erdemcanaz/MODBUS/README.md

# LoRa_Modbus
The goal of this project is to design a hardware implementation that enables wireless Modbus communication using the LoRa protocol.
