erdemcanaz/MODBUS/Device PCBs/Device-1/files/3D_image_1.png

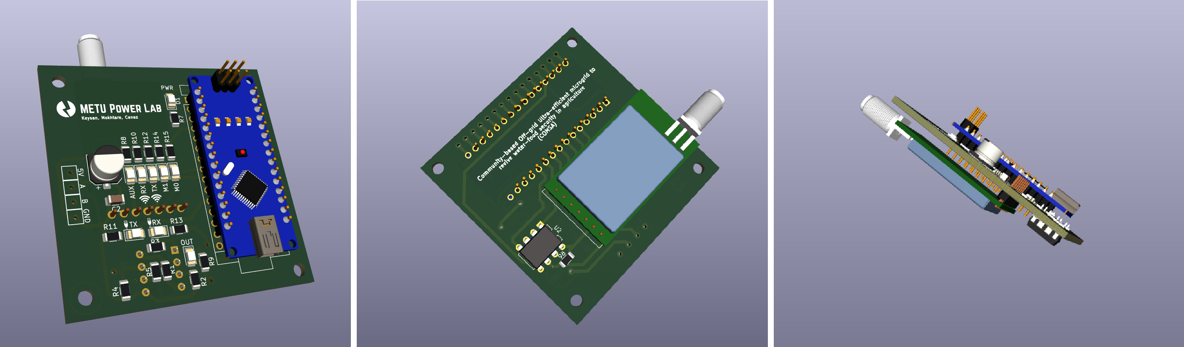
Device PCBs/Device-1/files/3D_image_1.png
