erdemcanaz/MODBUS/Device PCBs/Device-1/files/e32-433t20dt-1.snapshot.2/Anteckning 2020-03-28 171103.png

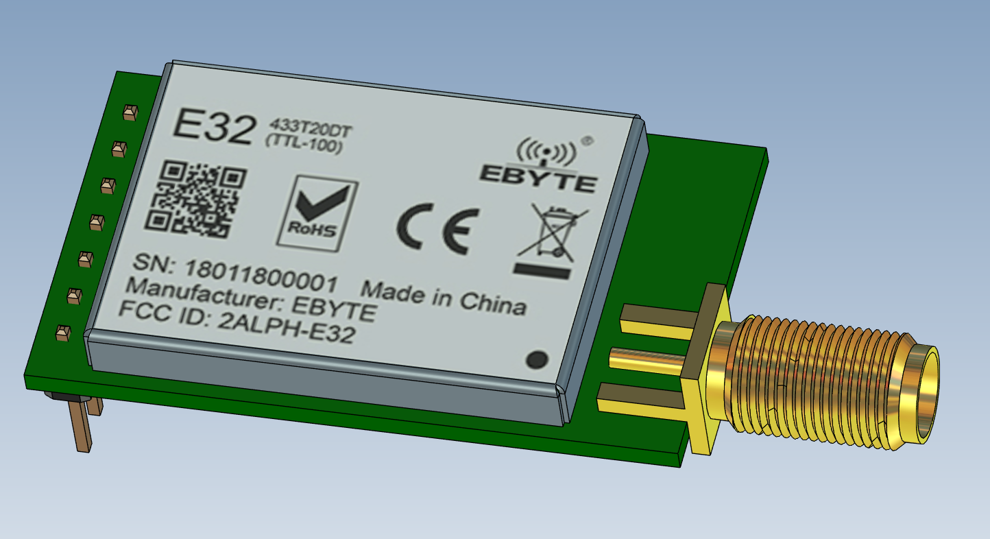
Device PCBs/Device-1/files/e32-433t20dt-1.snapshot.2/Anteckning 2020-03-28 171103.png
