erdemcanaz/MODBUS/Device PCBs/Device-1/files/example_RS485-TTL-schmatic.png

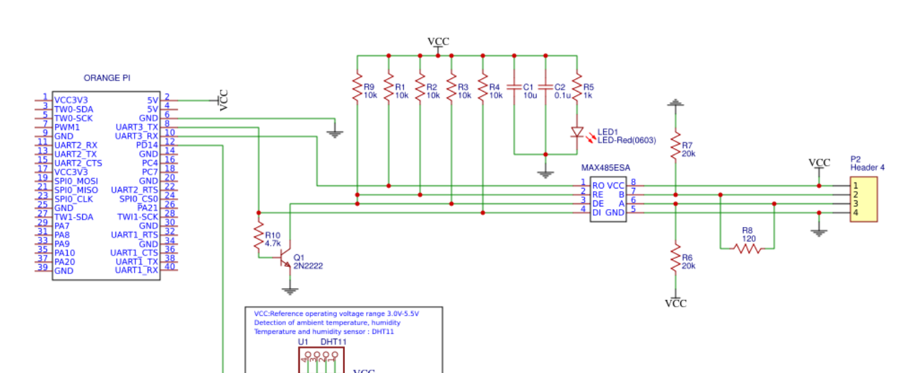
Device PCBs/Device-1/files/example_RS485-TTL-schmatic.png
