erdemcanaz/MODBUS/Device PCBs/Device-1/files/images.png

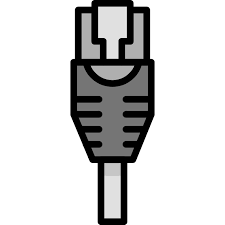
Device PCBs/Device-1/files/images.png
