erdemcanaz/MODBUS/Device PCBs/Device-1/files/render2.png

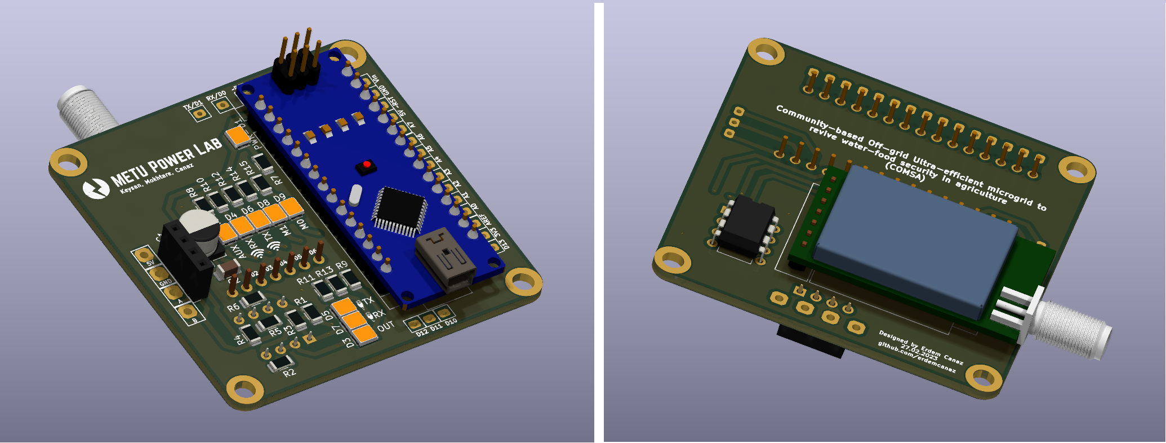
Device PCBs/Device-1/files/render2.png
