erdemcanaz/MODBUS/Device PCBs/Device-1/files/render.png

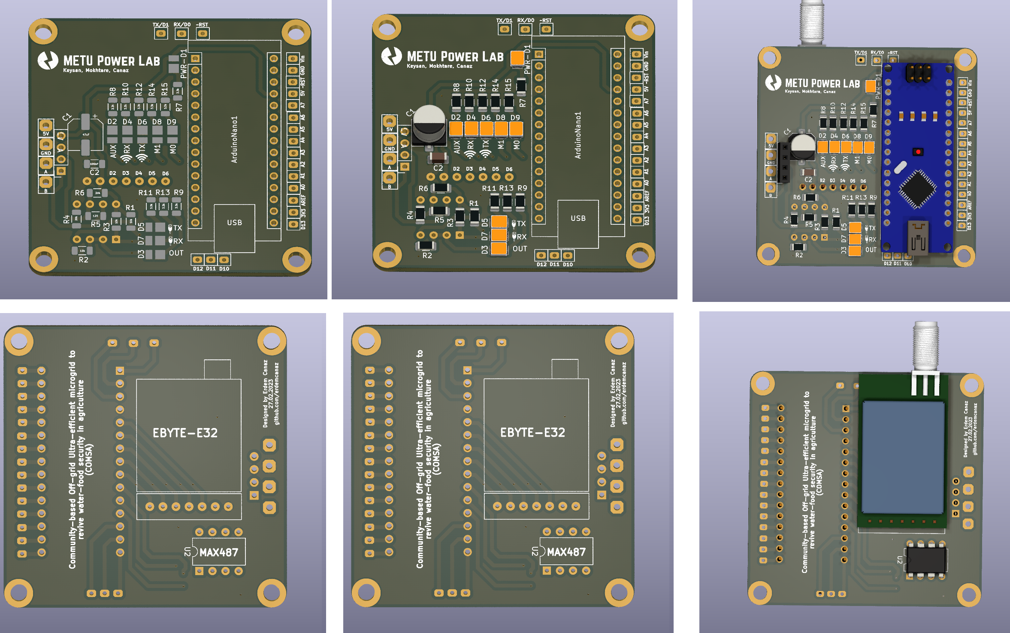
Device PCBs/Device-1/files/render.png
