erdemcanaz/MODBUS/Device PCBs/Device-1/files/RS485-TTL.png

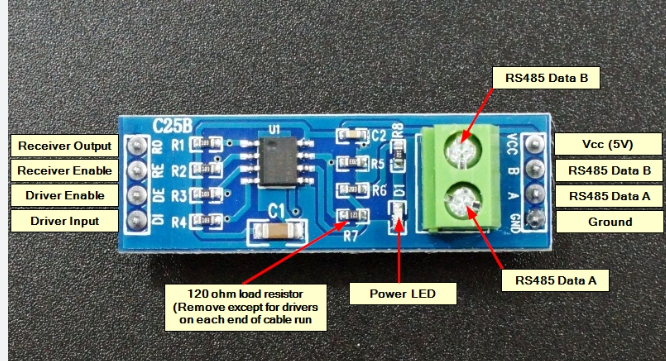
Device PCBs/Device-1/files/RS485-TTL.png
