erdemcanaz/MODBUS/Device PCBs/Device-1/files/samsung-lm281b-1.snapshot.3/lm281b/screenshot2.JPG

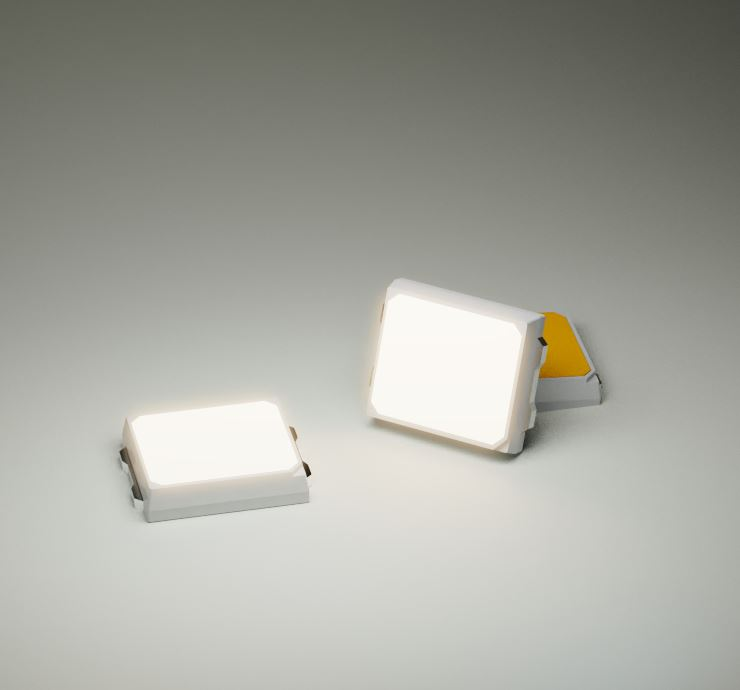
Device PCBs/Device-1/files/samsung-lm281b-1.snapshot.3/lm281b/screenshot2.JPG
