erdemcanaz/MODBUS/Device PCBs/Device-1/files/samsung-lm281b-1.snapshot.3/lm281b/screenshot.JPG

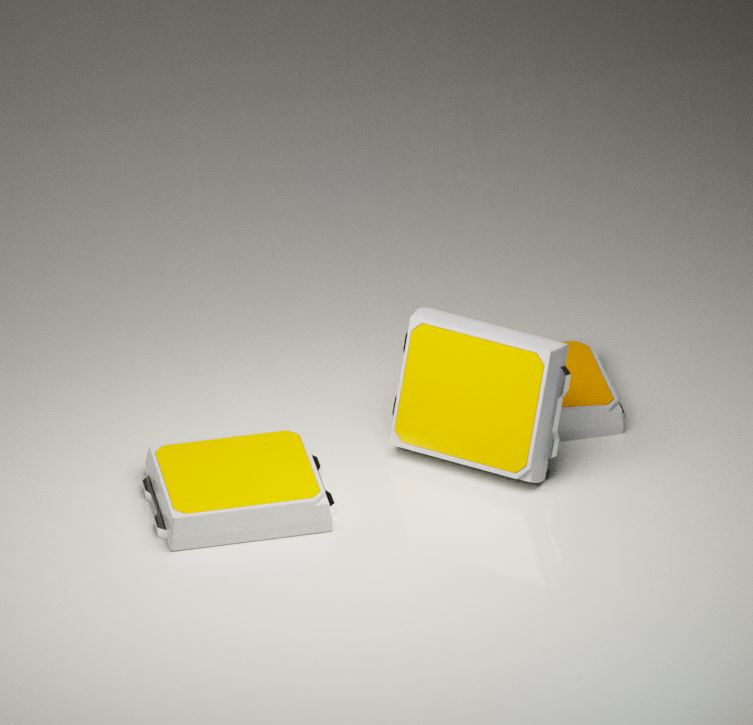
Device PCBs/Device-1/files/samsung-lm281b-1.snapshot.3/lm281b/screenshot.JPG
