erdemcanaz/MODBUS/Device PCBs/Device-1/files/wifi-chargement-gratuit-png-vecteurs-35.png

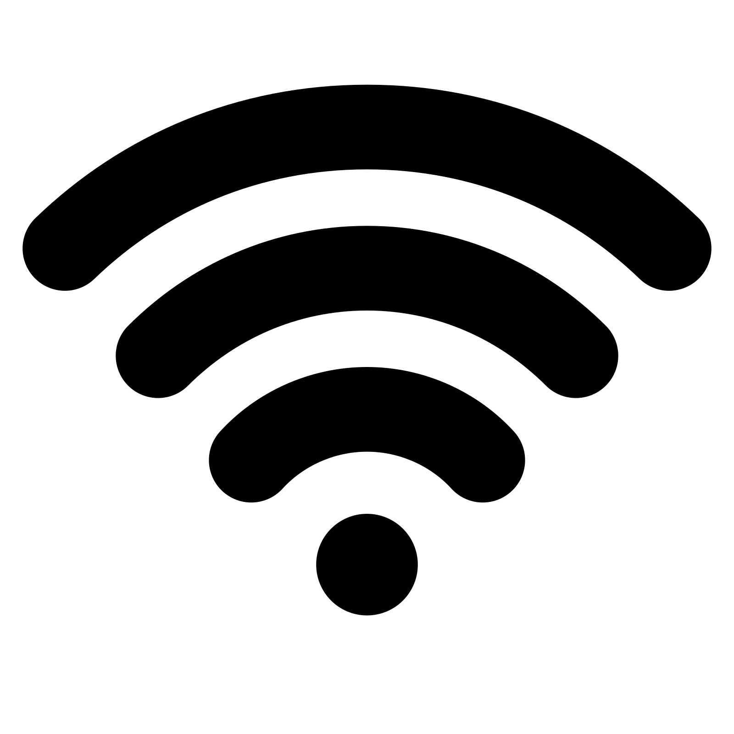
Device PCBs/Device-1/files/wifi-chargement-gratuit-png-vecteurs-35.png
