erdemcanaz/MODBUS/3D parts/Raspberry_Pi_3B__Case_3361218/README.txt

Raspberry Pi 3B+ Case by mkellsy on Thingiverse: https://www.thingiverse.com/thing:3361218
