erdemcanaz/MODBUS/3D parts/Raspberry_Pi_3B__Case_3361218/images/featured_preview_RPI3-1.PNG

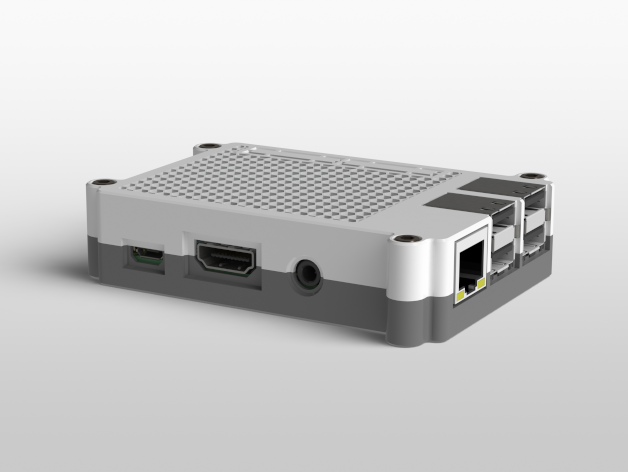
3D parts/Raspberry_Pi_3B__Case_3361218/images/featured_preview_RPI3-1.PNG
