erdemcanaz/MODBUS/Device PCBs/Device-1/files/samsung-lm281b-1.snapshot.3/lm281b/cad/lm281b full assembly.stp

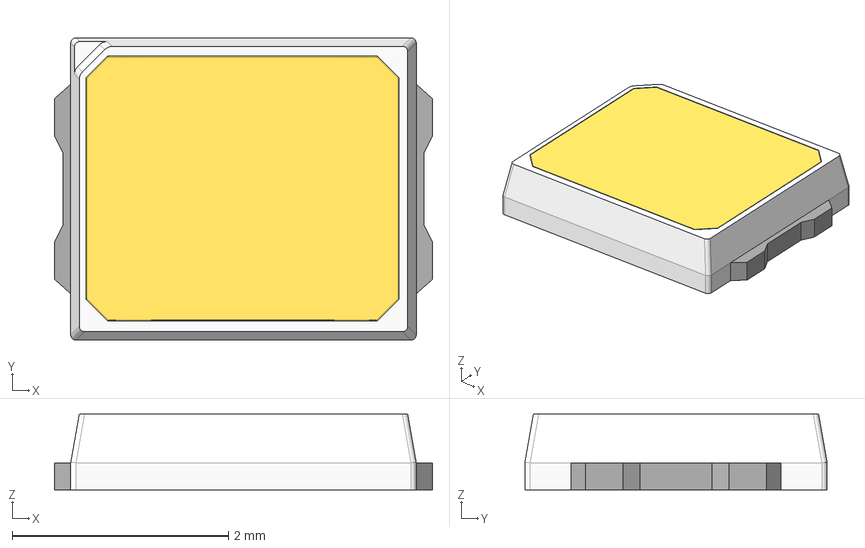
[picture p16: CAD file, 2023-05-01]
Device PCBs/Device-1/files/samsung-lm281b-1.snapshot.3/lm281b/cad/lm281b full assembly.stp
3.50 x 2.80 x 0.7 mm
lm281b body
lm281b luminofor
lm281b contact
