erdemcanaz/MODBUS/3D parts/Raspberry_Pi_3B__Case_3361218/files/RPI-BOARD-RETAINER.STL

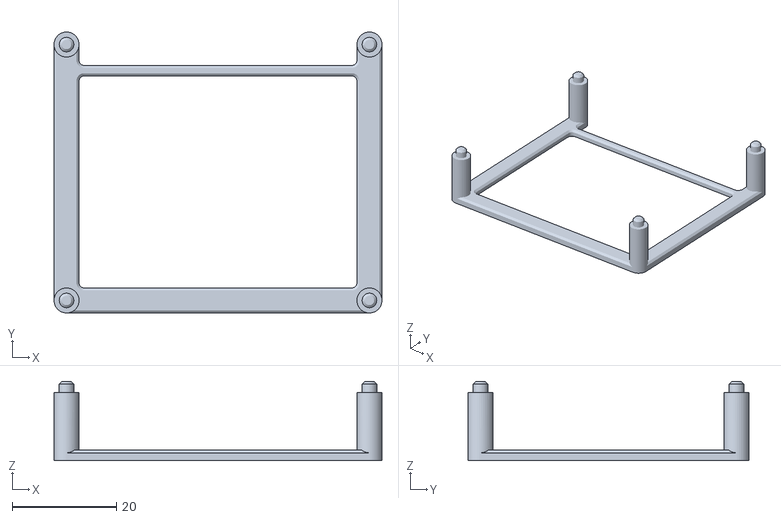
[picture p17: CAD file, 2023-06-25]
3D parts/Raspberry_Pi_3B__Case_3361218/files/RPI-BOARD-RETAINER.STL
62.8 x 53.8 x 15.2
