erdemcanaz/MODBUS/Device PCBs/Device-1/files/arduino-nano-30.snapshot.1/Arduino Nano.SLDPRT

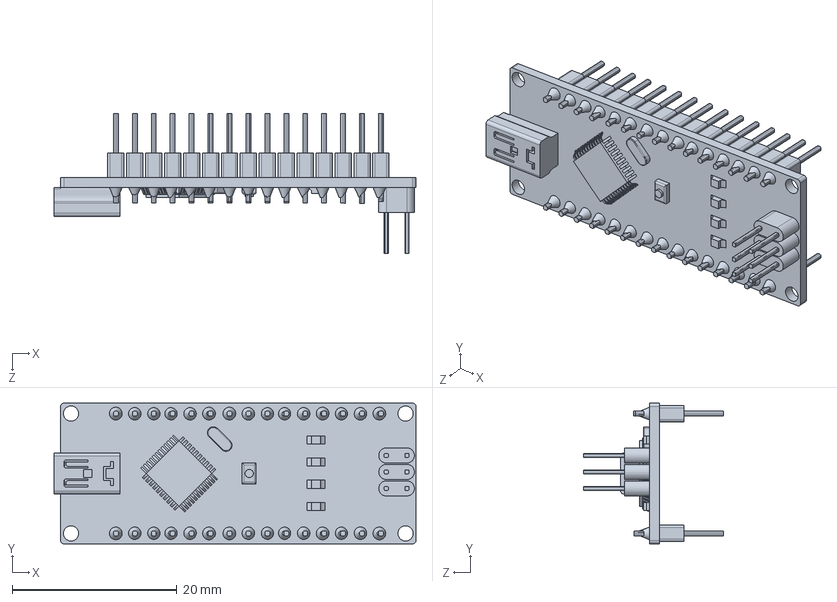
[picture p18: CAD file, 2023-05-01]
Device PCBs/Device-1/files/arduino-nano-30.snapshot.1/Arduino Nano.SLDPRT
44.0 x 17.1 x 17.0 mm
