erdemcanaz/MODBUS/Device PCBs/Device-1/files/e32-433t20dt-1.snapshot.2/E32-433T20DT.stp

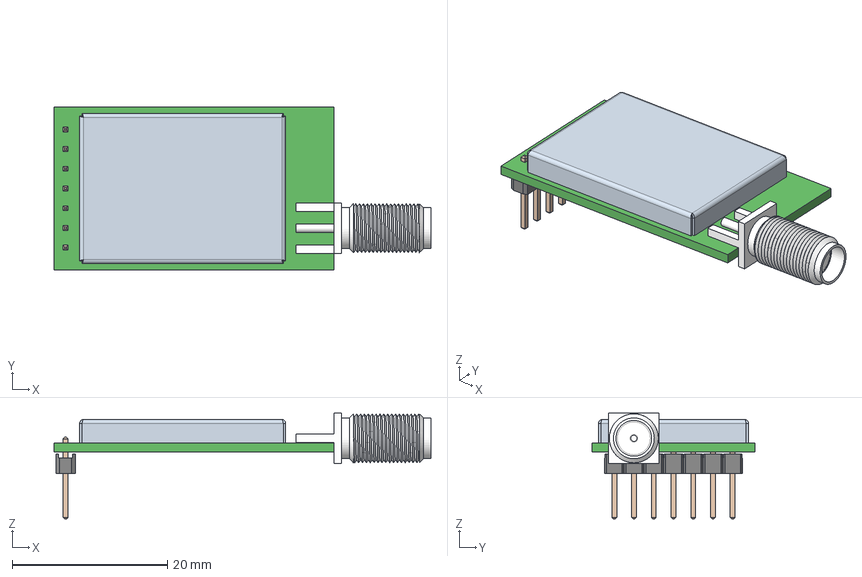
[picture p19: CAD file, 2023-05-01]
Device PCBs/Device-1/files/e32-433t20dt-1.snapshot.2/E32-433T20DT.stp
48.5 x 21.0 x 13.6 mm
Pin x 7
Spin
Base
PCB
RFbox
