erdemcanaz/MODBUS/3D parts/Lora Casing V9.stl

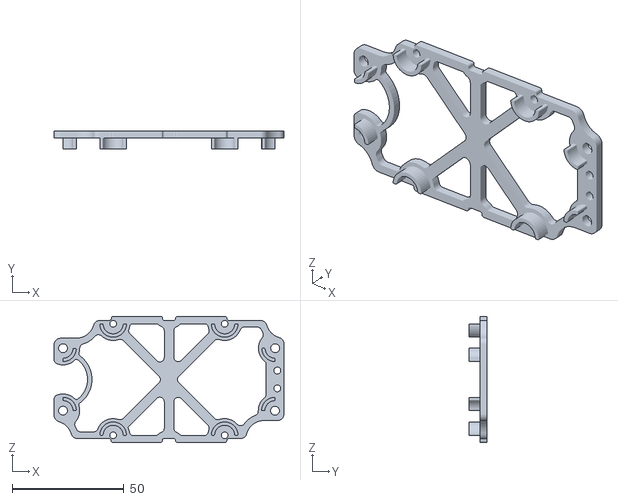
[picture p20: CAD file, 2023-05-01]
3D parts/Lora Casing V9.stl
103.1 x 8.00 x 56.5
