erdemcanaz/MODBUS/3D parts/Raspberry_Pi_3B__Case_3361218/files/RPI-TOP-25FAN-BLANK.STL

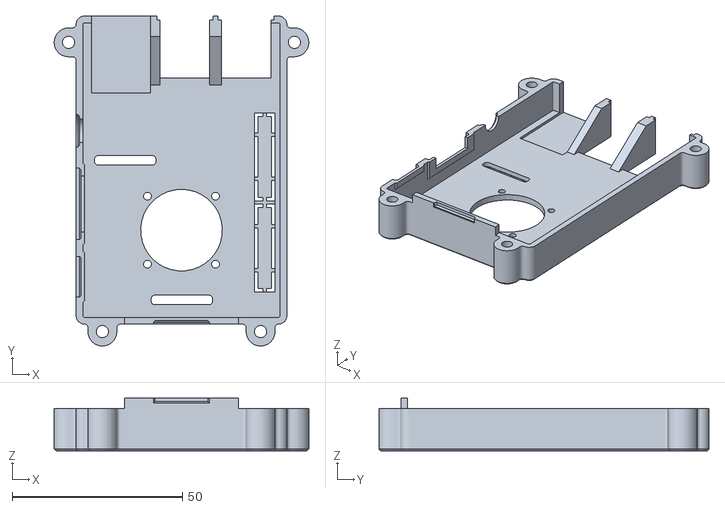
[picture p21: CAD file, 2023-06-25]
3D parts/Raspberry_Pi_3B__Case_3361218/files/RPI-TOP-25FAN-BLANK.STL
74.9 x 97.0 x 15.5
