erdemcanaz/MODBUS/3D parts/Raspberry_Pi_3B__Case_3361218/files/RPI-BOTTOM-100VESA.STL

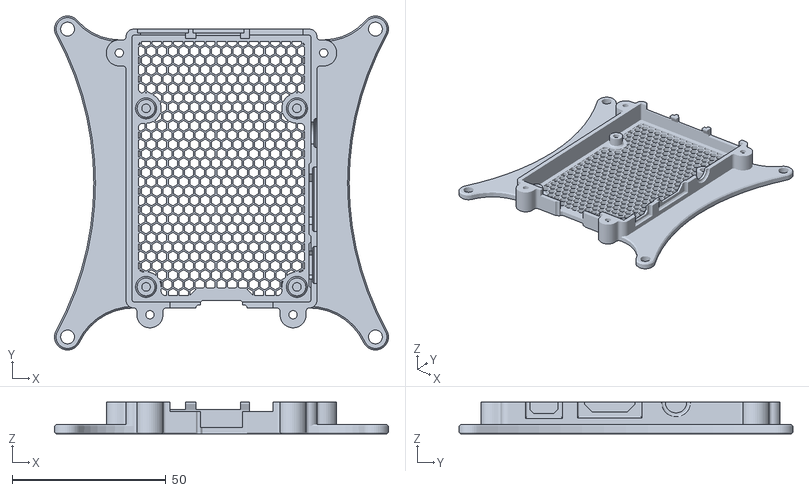
[picture p22: CAD file, 2023-06-25]
3D parts/Raspberry_Pi_3B__Case_3361218/files/RPI-BOTTOM-100VESA.STL
108.5 x 108.5 x 10.3
