erdemcanaz/MODBUS/3D parts/Raspberry_Pi_3B__Case_3361218/files/RPI-TOP-25FAN.STL

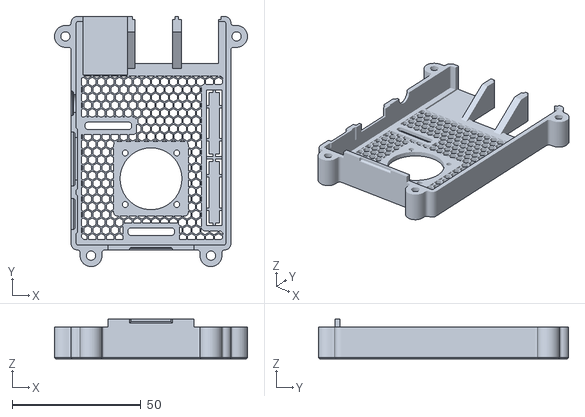
[picture p25: CAD file, 2023-06-25]
3D parts/Raspberry_Pi_3B__Case_3361218/files/RPI-TOP-25FAN.STL
74.9 x 97.0 x 15.5
