erdemcanaz/MODBUS/3D parts/Raspberry_Pi_3B__Case_3361218/files/RPI-BOTTOM.STL

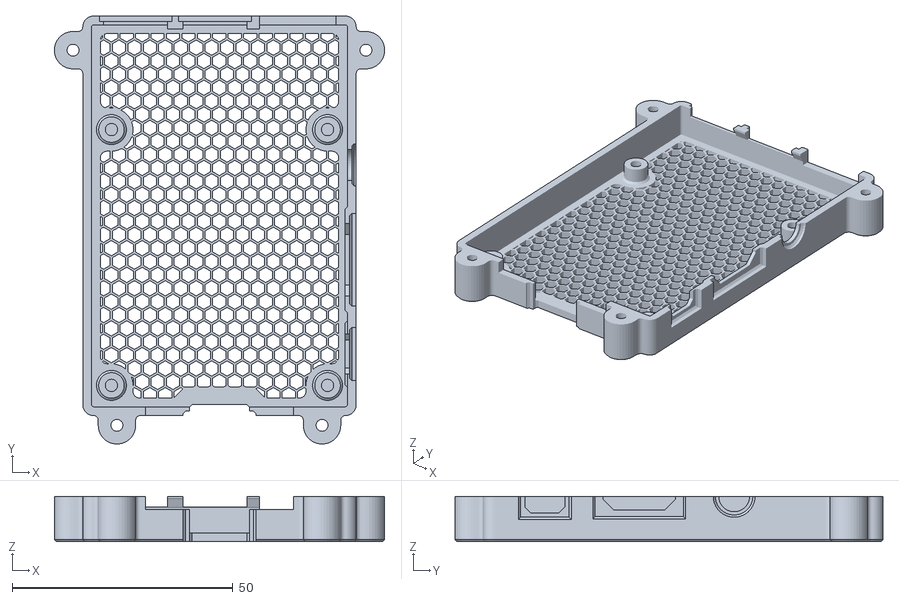
[picture p26: CAD file, 2023-06-25]
3D parts/Raspberry_Pi_3B__Case_3361218/files/RPI-BOTTOM.STL
74.9 x 97.0 x 10.3
