erdemcanaz/MODBUS/3D parts/Raspberry_Pi_3B__Case_3361218/files/RPI-BOTTOM-8020.STL

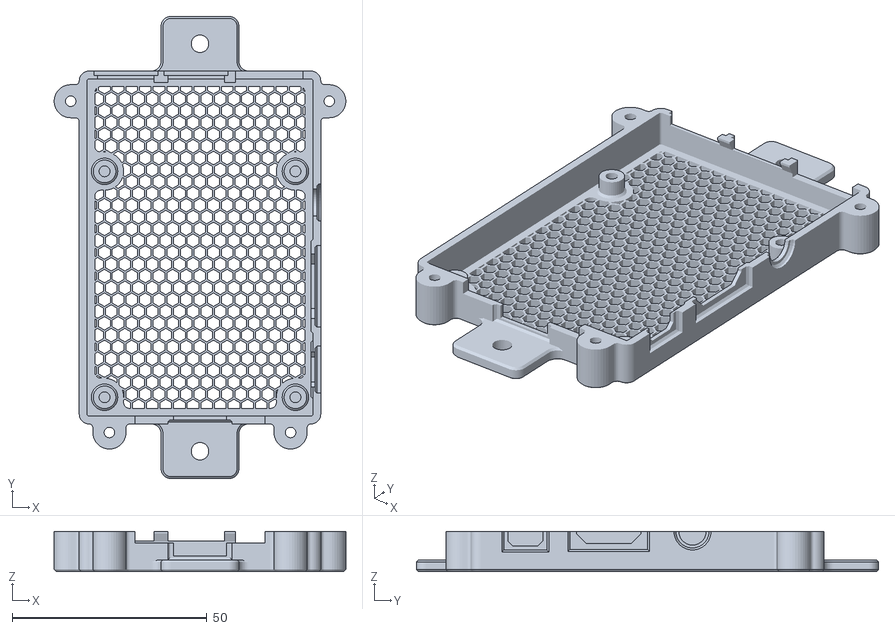
[picture p28: CAD file, 2023-06-25]
3D parts/Raspberry_Pi_3B__Case_3361218/files/RPI-BOTTOM-8020.STL
74.9 x 118.6 x 10.3
