erdemcanaz/MODBUS/3D parts/Raspberry_Pi_3B__Case_3361218/files/RPI-BOTTOM-75VESA.STL

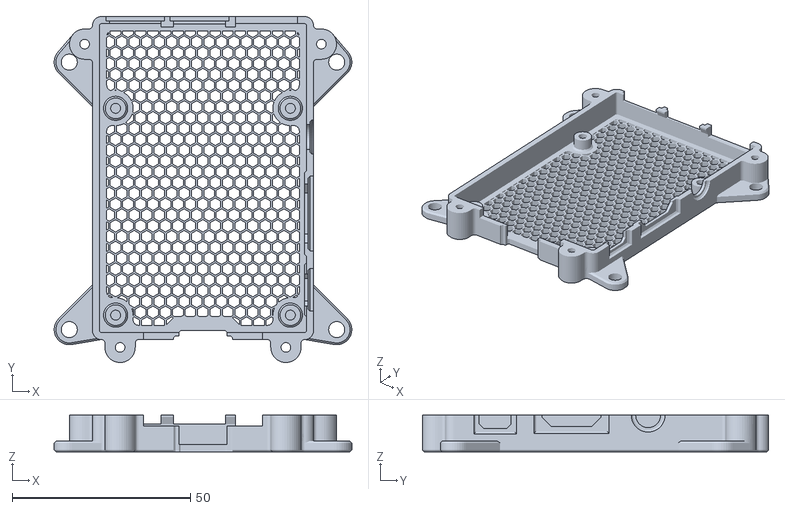
[picture p29: CAD file, 2023-06-25]
3D parts/Raspberry_Pi_3B__Case_3361218/files/RPI-BOTTOM-75VESA.STL
83.5 x 97.0 x 10.3
