erdemcanaz/MODBUS/(list of files, cad)

Other CAD files:
Device PCBs/Device-1/files/arduino-nano-30.snapshot.1/Arduino Nano-STEP.STEP
3D parts/Raspberry_Pi_3B__Case_3361218/files/RPI-TOP-30FAN-BLANK.STL
3D parts/Raspberry_Pi_3B__Case_3361218/files/RPI-TOP-BLANK.STL
3D parts/Raspberry_Pi_3B__Case_3361218/files/RPI-TOP-30FAN.STL
3D parts/lora casing v8.stl
Device PCBs/Device-1/files/e32-433t20dt-1.snapshot.2/e32-433t20dt.X_T
Device PCBs/Device-1/files/samsung-lm281b-1.snapshot.3/lm281b/cad/lm281b body.prt
Device PCBs/Device-1/files/samsung-lm281b-1.snapshot.3/lm281b/cad/lm281b contact.prt
Device PCBs/Device-1/files/samsung-lm281b-1.snapshot.3/lm281b/cad/lm281b full assembly.obj
Device PCBs/Device-1/files/samsung-lm281b-1.snapshot.3/lm281b/cad/lm281b full assembly.prt
Device PCBs/Device-1/files/samsung-lm281b-1.snapshot.3/lm281b/cad/lm281b luminofor.prt
