erdemcanaz/MODBUS/Device PCBs/Device-1/files/schematic_25_02_2023.pdf

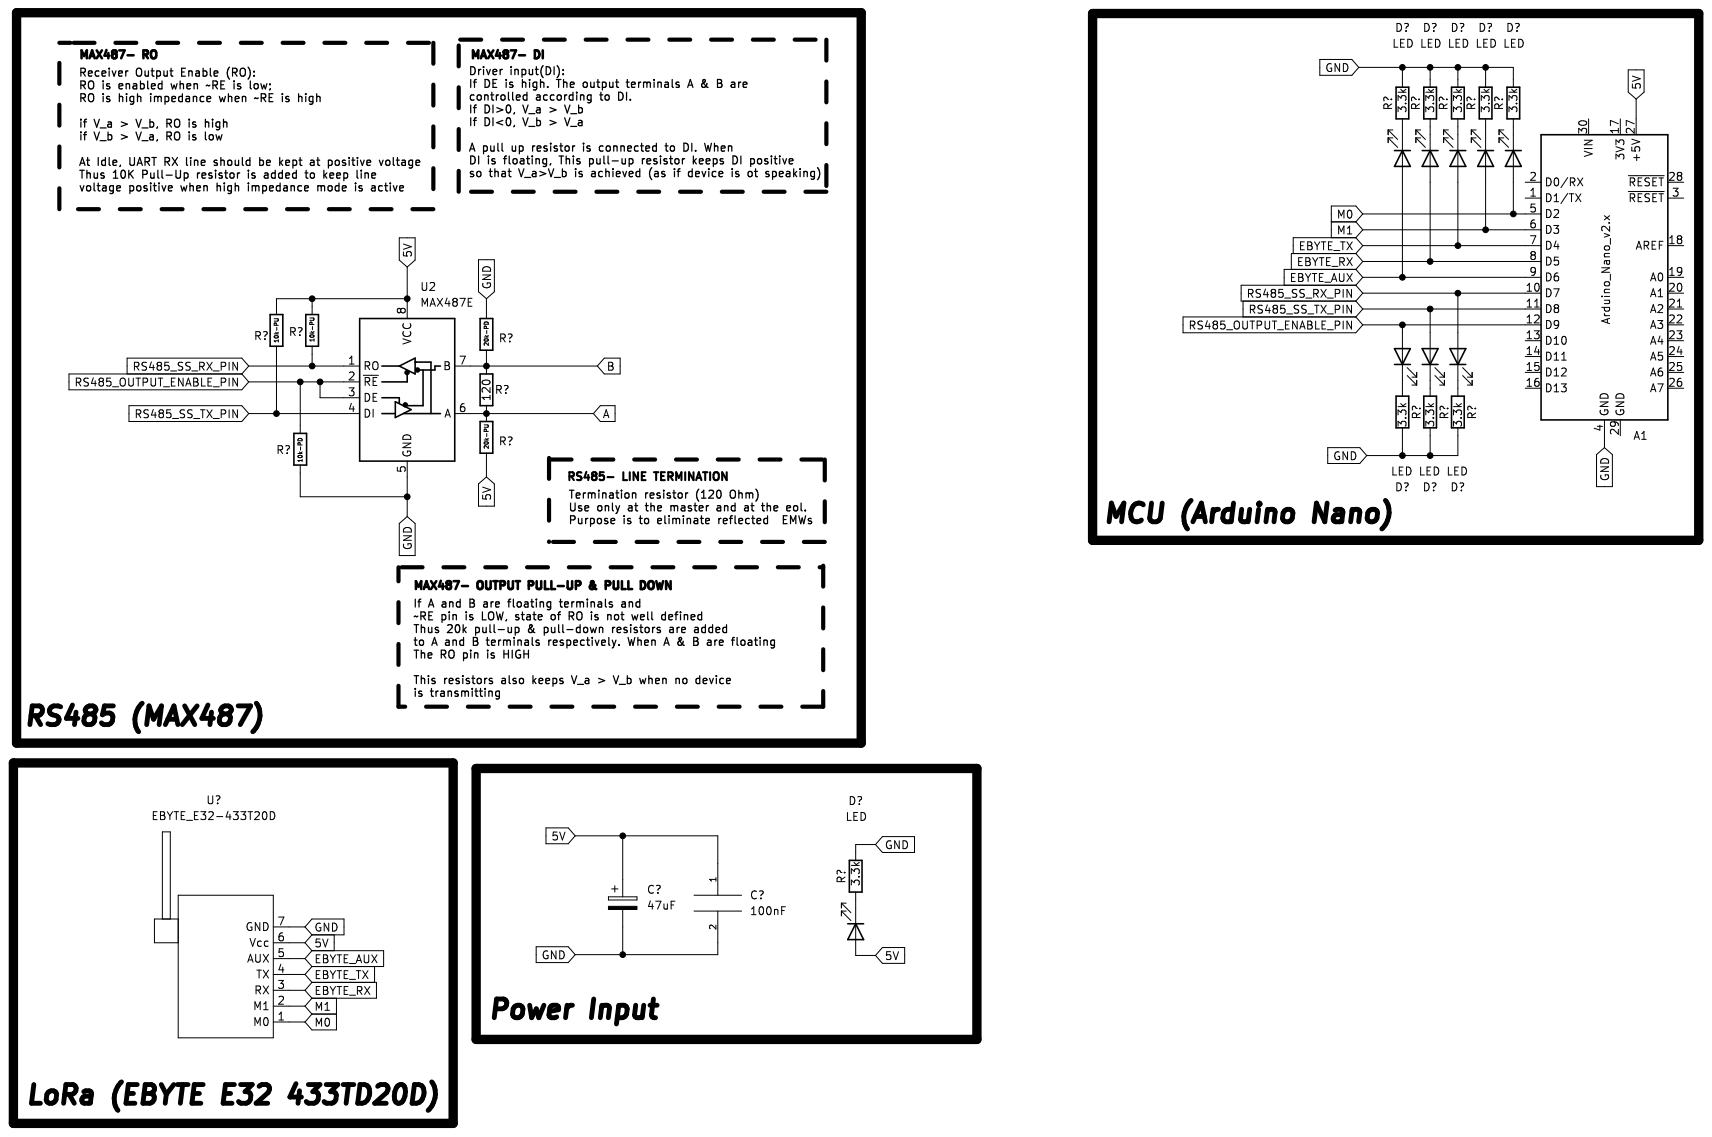
[picture p38: page 1]
