erdemcanaz/MODBUS/Device PCBs/Device-1/files/schematic_25_02_2023_2.pdf

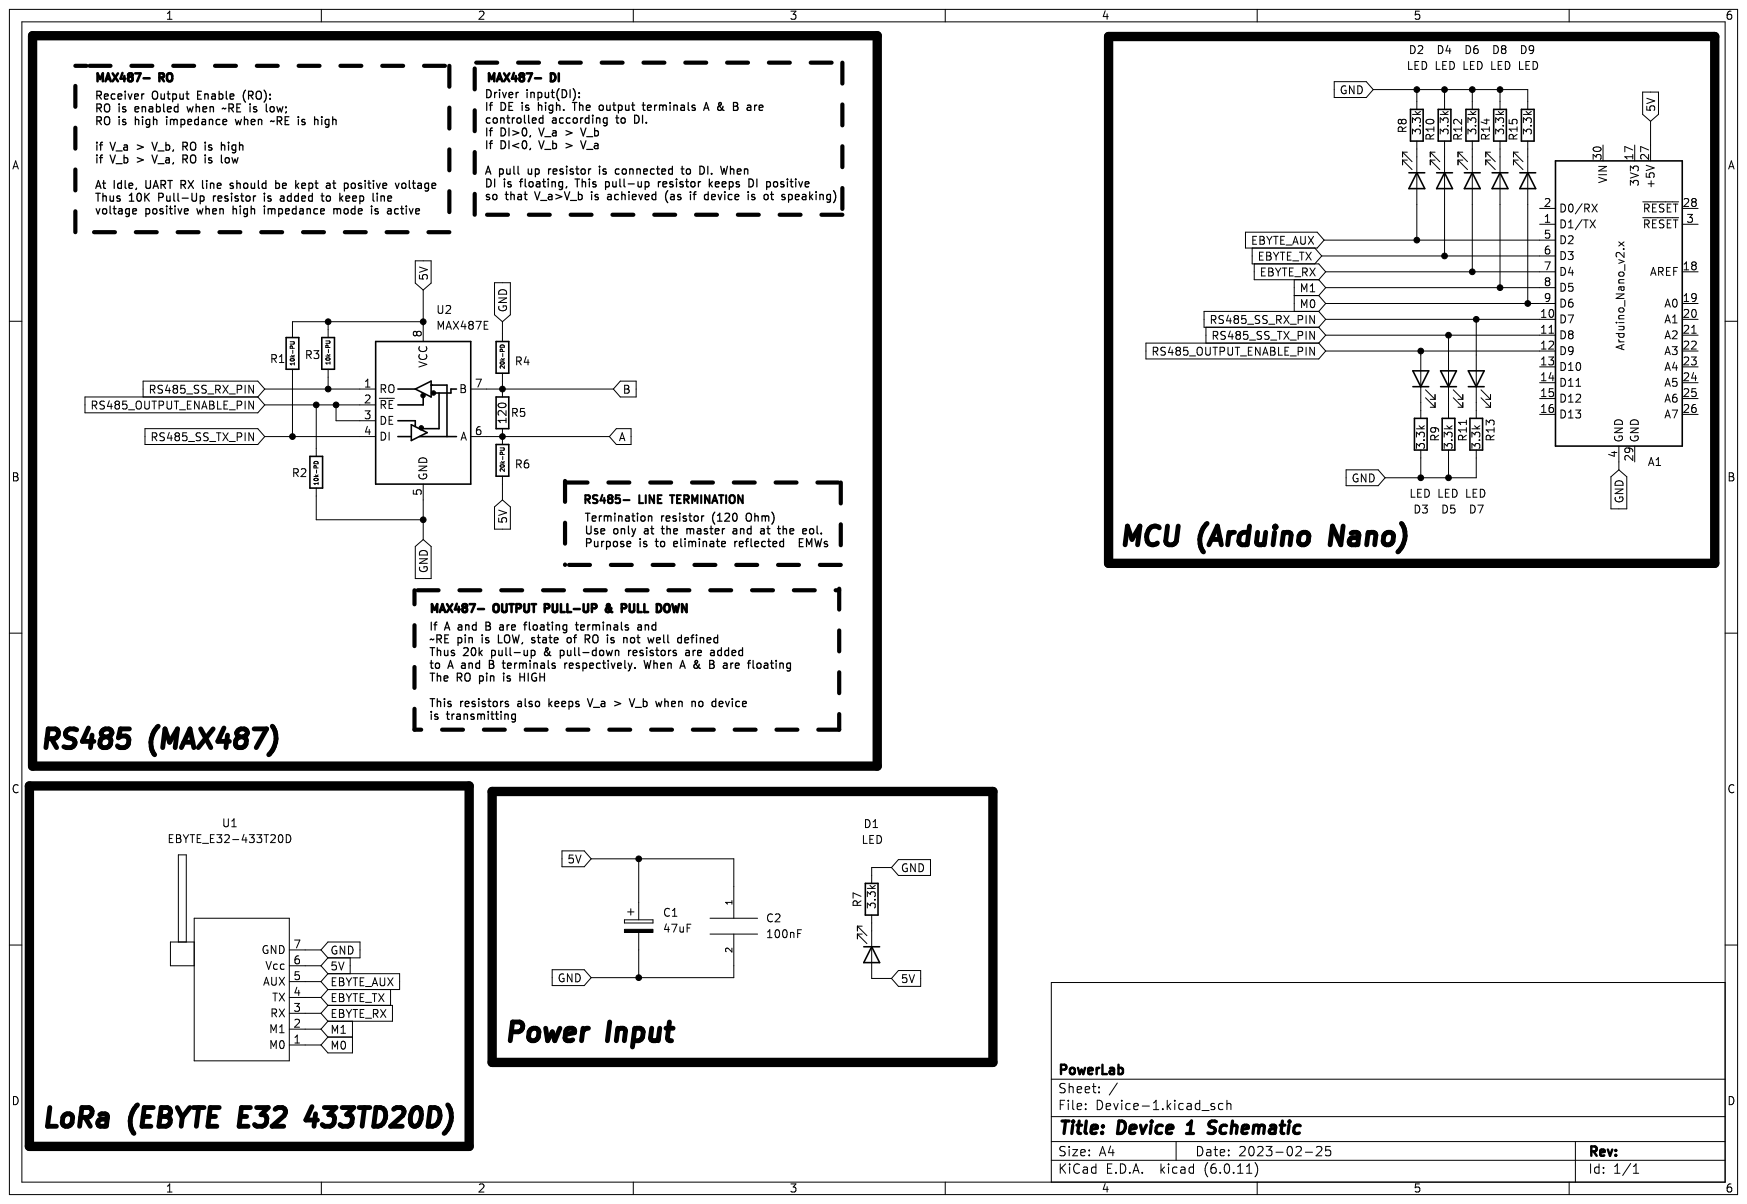
[picture p39: page 1]
