erdemcanaz/MODBUS/Device PCBs/Device-1/PCB pdfs/Device-1-B_Cu.pdf

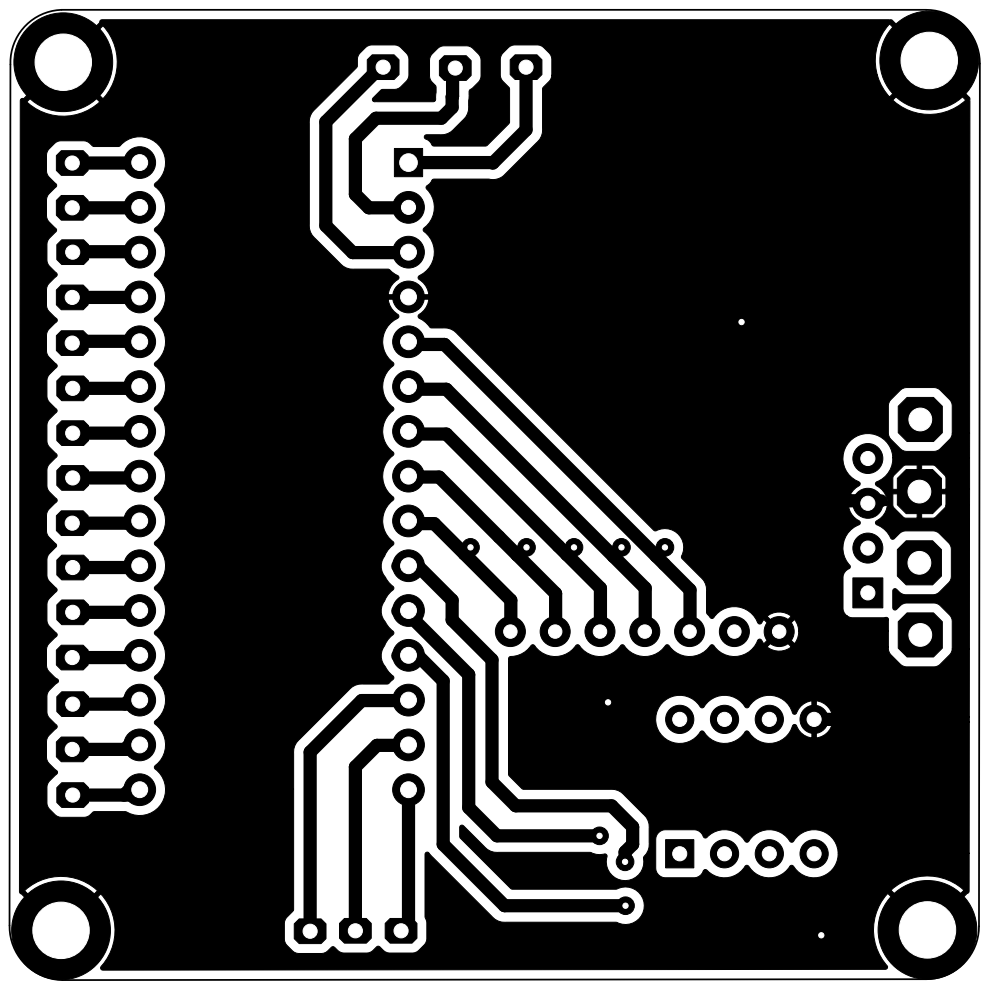
[picture p40: page 1]
