erdemcanaz/MODBUS/Device PCBs/Device-1/PCB pdfs/Device-1-B_Silkscreen.pdf

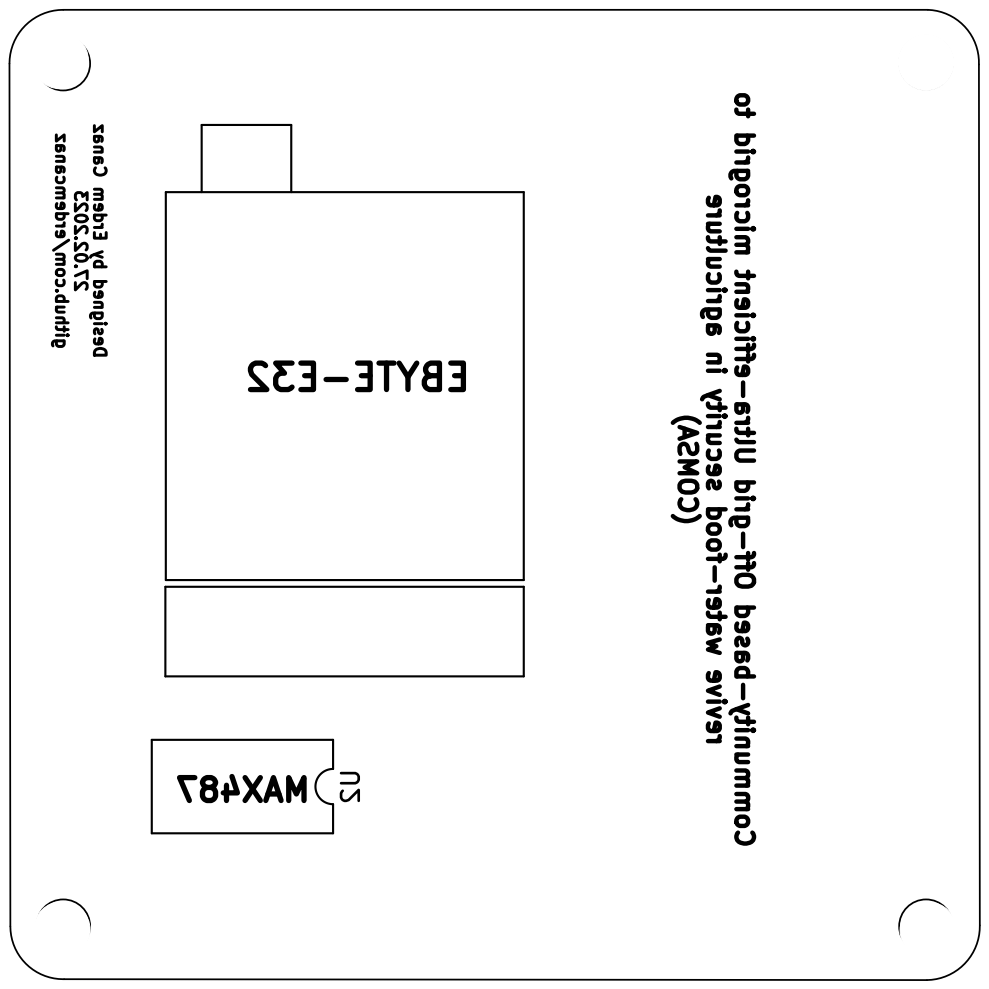
[picture p41: page 1]

Designed by Erdem Canaz 27.02.2023 github.com/erdemcanaz MAX487 EBYTE-E32 Community-based Off-grid Ultra-efficient microgrid to revive water-food security in agriculture (COMSA) U2
