erdemcanaz/MODBUS/Device PCBs/Device-1/PCB pdfs/Device-1-F_Cu.pdf

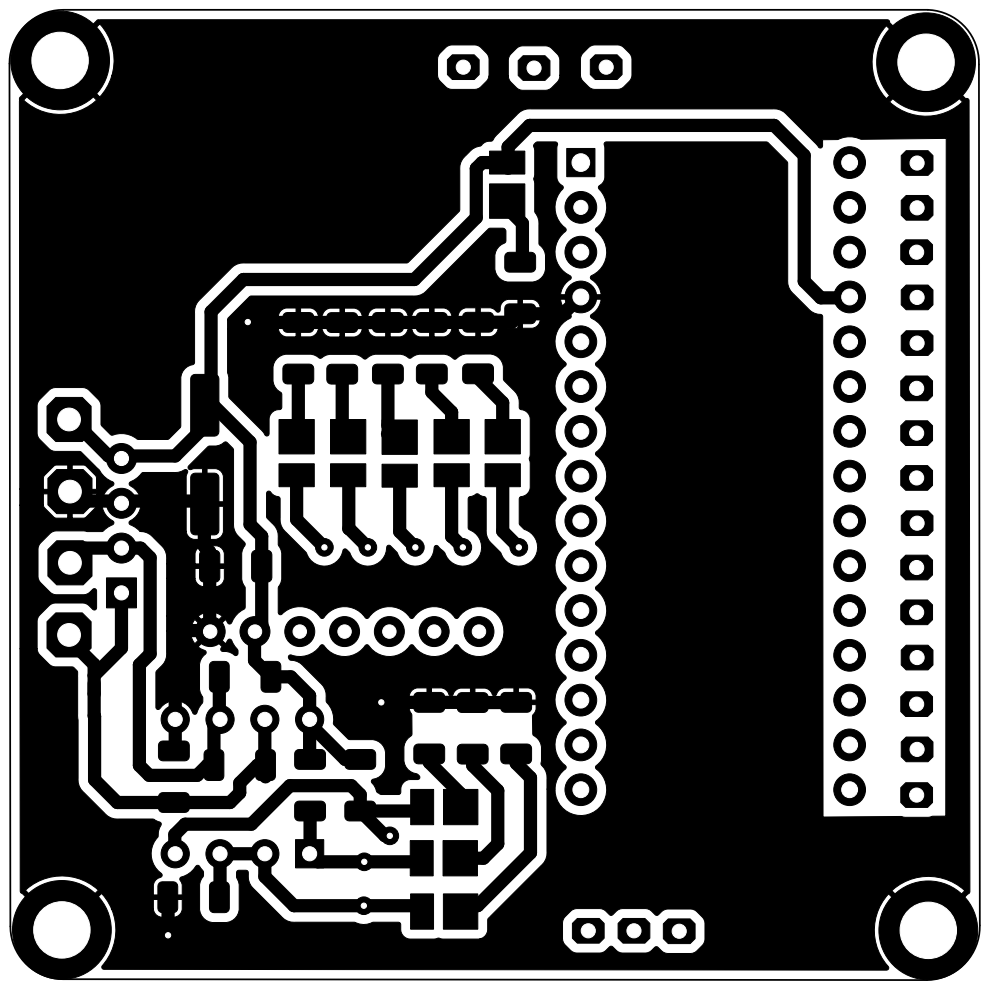
[picture p42: page 1]
