erdemcanaz/MODBUS/Device PCBs/Device-1/PCB pdfs/Device-1-F_Silkscreen.pdf

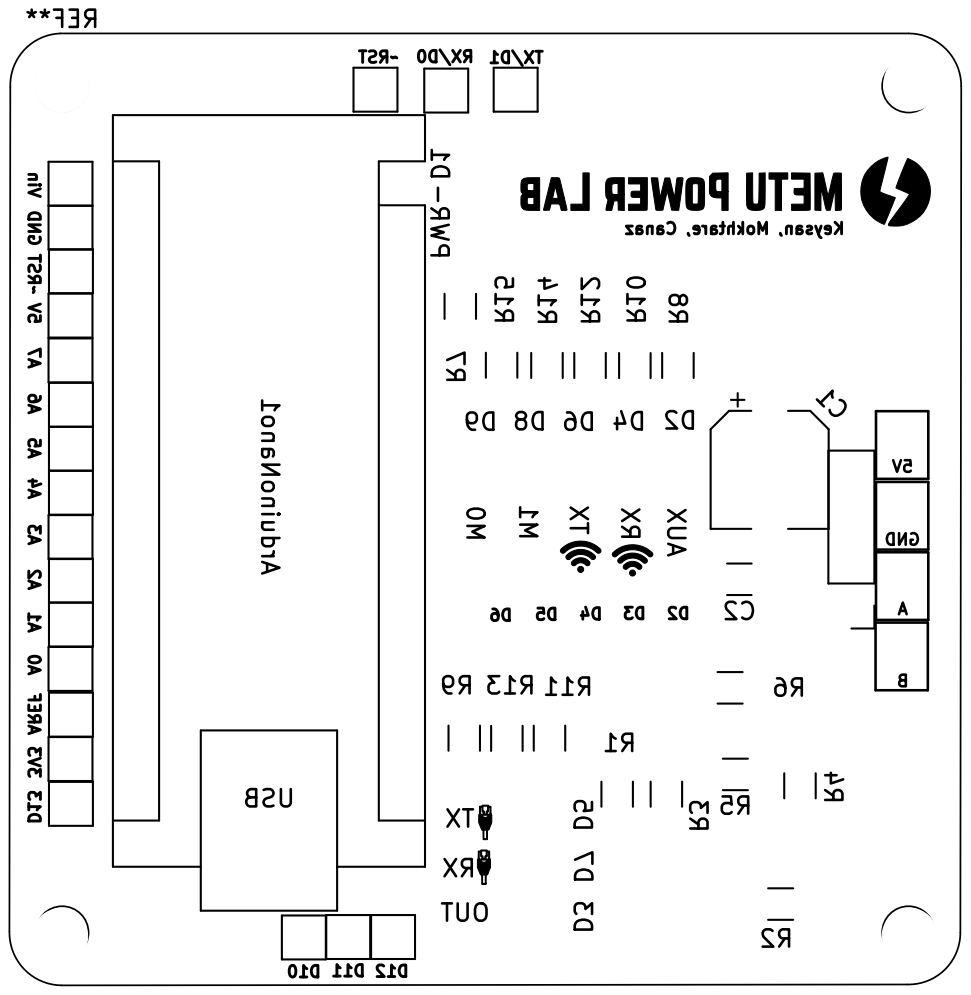
[picture p43: page 1]

A2 Canaz Mokhtare, Keysan, AREF D10 A1 AUX
