erdemcanaz/MODBUS/Device PCBs/Device-1/Device-1.kicad_pcb

## KiCad design Device PCBs/Device-1/Device-1.kicad_pcb (2023-05-01)

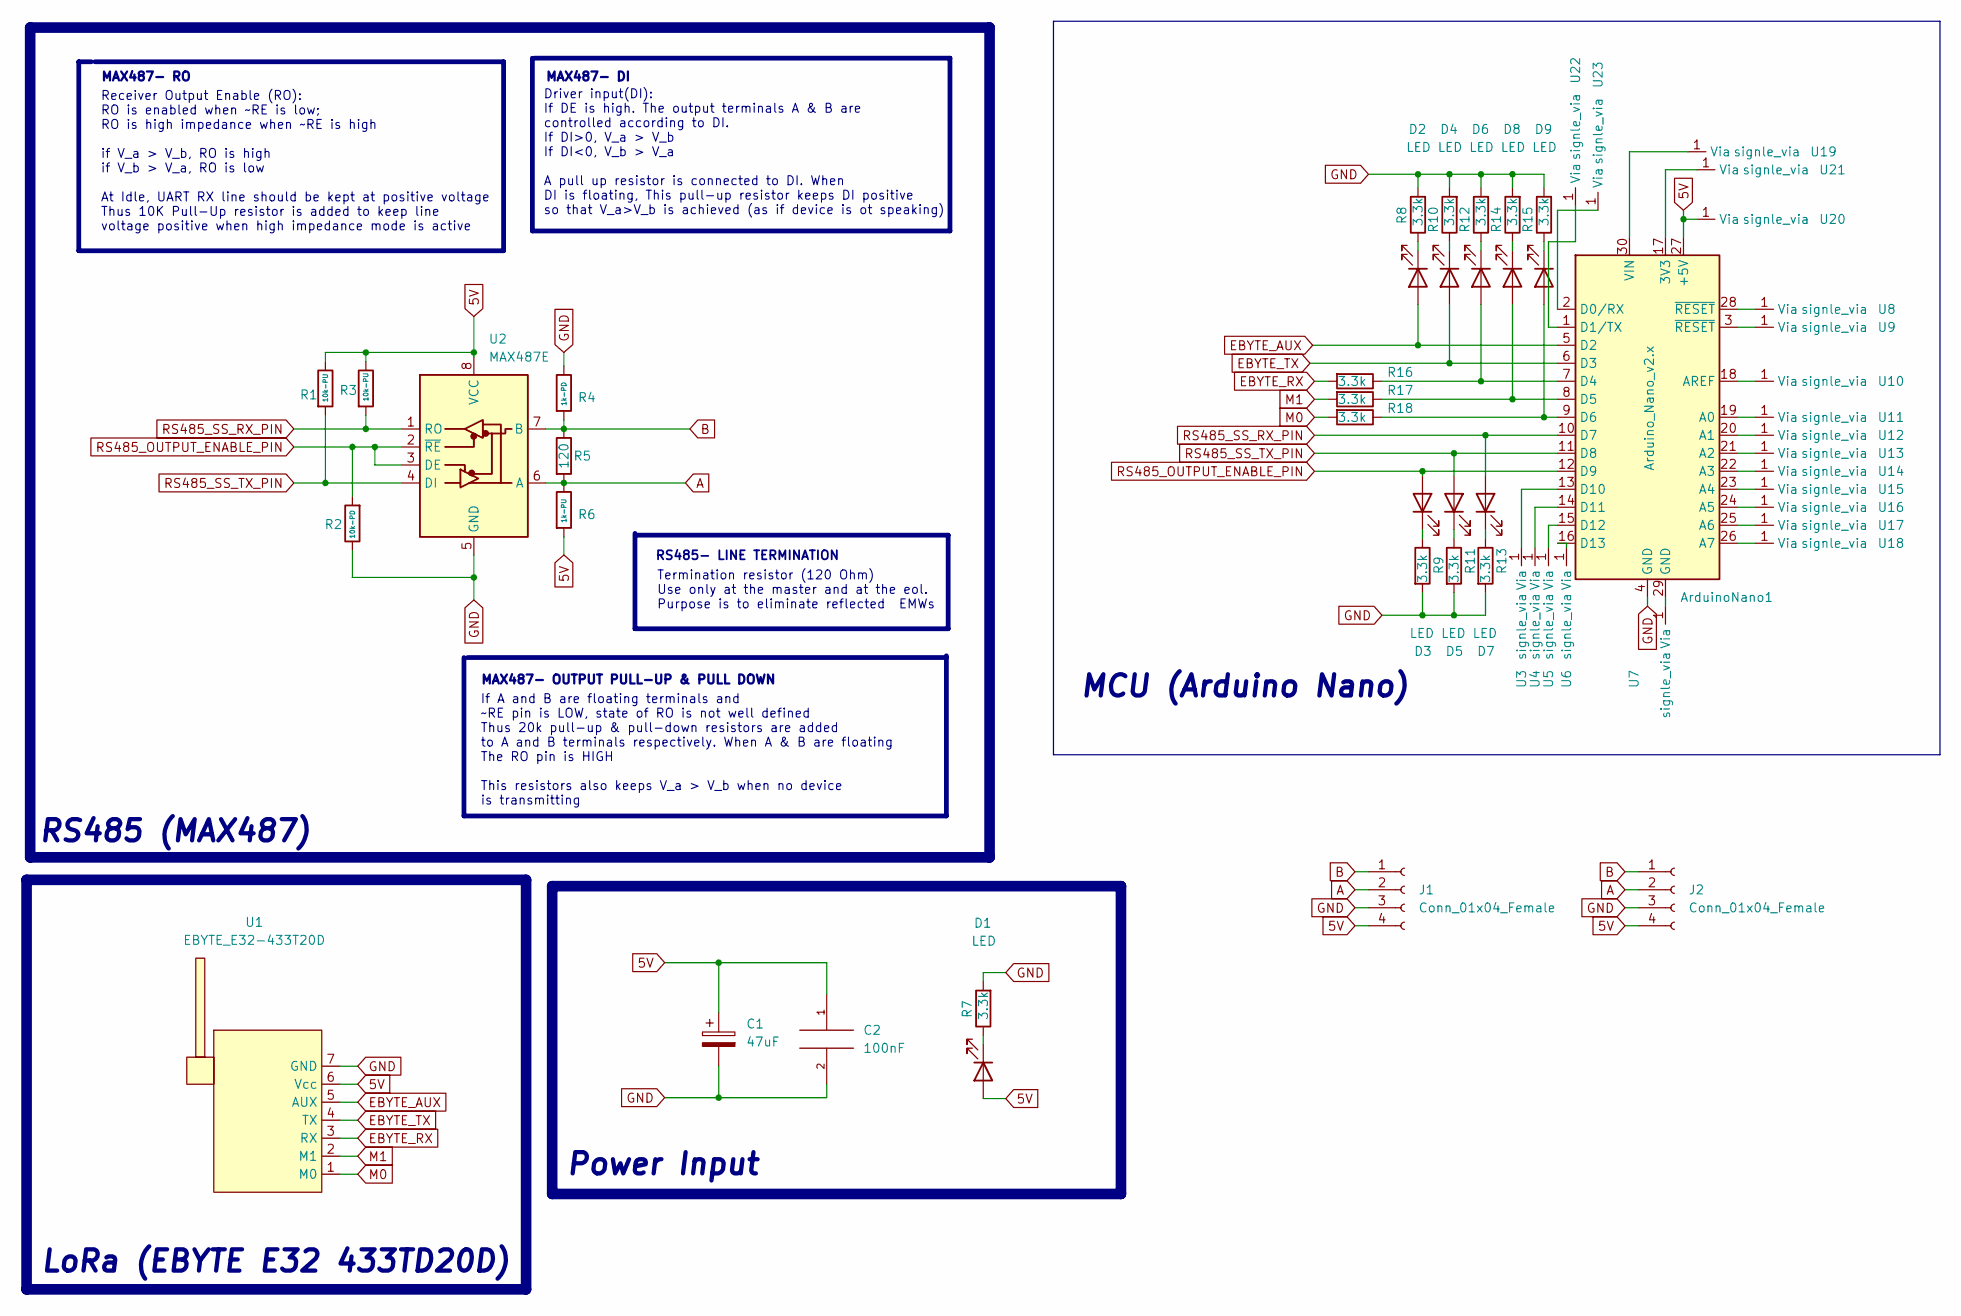
[picture p44: schematic Device-1.kicad_sch, Device 1 Schematic]

Parts:
ArduinoNano1: Arduino_Nano_v2.x; Arduino_Nano
C1: 47uF; CP_Elec_6.3x5.2
C2: 100nF; C_1206_3216Metric
D1, D2, D3, D8, D9: LED; lm281B-3000K
D4, D5, D6, D7: LED; lm281B-6500K
J1: Conn_01x04_Female; PinSocket_1x04_P2.54mm_Vertical
J2: Conn_01x04_Female; output_vias
R1, R3: 10k-PU; R_1206_3216Metric
R2: 10k-PD; R_1206_3216Metric
R4: 1k-PD; R_1206_3216Metric
R5: 120; R_1206_3216Metric
R6: 1k-PU; R_1206_3216Metric
R7, R8, R9, R10, R11, R12, R13, R14, R15, R16, R17, R18: 3.3k; R_1206_3216Metric
U1: EBYTE_E32-433T20D; EBYTE-E32-433T20D
U2: MAX487E; DIP-8_W7.62mm
U3, U4, U5, U6, U7, U8, U9, U10, U11, U12, U13, U14, U15, U16, U17, U18, U19, U20, U21, U22, U23: signle_via; single_via

Connections:
5V: ArduinoNano1.27 (+5V), C1.1, C2.1, D1.2 (A), J1.4, J2.4, R1.1, R3.1, R6.2, U1.6 (Vcc), U2.8 (VCC), U20.1 (Via)
A: J1.2, J2.2, R5.2, R6.1, U2.6 (A)
B: J1.1, J2.1, R4.2, R5.1, U2.7 (B)
EBYTE_AUX: ArduinoNano1.5 (D2), D2.2 (A), U1.5 (AUX)
EBYTE_RX: R16.2, U1.3 (RX)
EBYTE_TX: ArduinoNano1.6 (D3), D4.2 (A), U1.4 (TX)
GND: ArduinoNano1.4 (GND), C1.2, C2.2, J1.3, J2.3, R2.1, R4.1, R7.2, R8.2, R9.2, R10.2, R11.2, R12.2, R13.2, R14.2, R15.2, U1.7 (GND), U2.5 (GND)
M0: R18.2, U1.1 (M0)
M1: R17.2, U1.2 (M1)
unnamed: ArduinoNano1.1 (D1/TX), U22.1 (Via)
unnamed: ArduinoNano1.2 (D0/RX), U23.1 (Via)
unnamed: ArduinoNano1.3 (~RESET), U9.1 (Via)
unnamed: ArduinoNano1.7 (D4), D6.2 (A), R16.1
unnamed: ArduinoNano1.8 (D5), D8.2 (A), R17.1
unnamed: ArduinoNano1.9 (D6), D9.2 (A), R18.1
unnamed: ArduinoNano1.13 (D10), U3.1 (Via)
unnamed: ArduinoNano1.14 (D11), U4.1 (Via)
unnamed: ArduinoNano1.15 (D12), U5.1 (Via)
unnamed: ArduinoNano1.16 (D13), U6.1 (Via)
unnamed: ArduinoNano1.17 (3V3), U21.1 (Via)
unnamed: ArduinoNano1.18 (AREF), U10.1 (Via)
unnamed: ArduinoNano1.19 (A0), U11.1 (Via)
unnamed: ArduinoNano1.20 (A1), U12.1 (Via)
unnamed: ArduinoNano1.21 (A2), U13.1 (Via)
unnamed: ArduinoNano1.22 (A3), U14.1 (Via)
unnamed: ArduinoNano1.23 (A4), U15.1 (Via)
unnamed: ArduinoNano1.24 (A5), U16.1 (Via)
unnamed: ArduinoNano1.25 (A6), U17.1 (Via)
unnamed: ArduinoNano1.26 (A7), U18.1 (Via)
unnamed: ArduinoNano1.28 (~RESET), U8.1 (Via)
unnamed: ArduinoNano1.29 (GND), U7.1 (Via)
unnamed: ArduinoNano1.30 (VIN), U19.1 (Via)
unnamed: D1.1 (K), R7.1
unnamed: D2.1 (K), R8.1
unnamed: D3.1 (K), R9.1
unnamed: D4.1 (K), R10.1
unnamed: D5.1 (K), R11.1
unnamed: D6.1 (K), R12.1
unnamed: D7.1 (K), R13.1
unnamed: D8.1 (K), R14.1
unnamed: D9.1 (K), R15.1
RS485_OUTPUT_ENABLE_PIN: ArduinoNano1.12 (D9), D3.2 (A), R2.2, U2.2 (~RE), U2.3 (DE)
RS485_SS_RX_PIN: ArduinoNano1.10 (D7), D7.2 (A), R3.2, U2.1 (RO)
RS485_SS_TX_PIN: ArduinoNano1.11 (D8), D5.2 (A), R1.2, U2.4 (DI)

Notes on the sheet:
MAX487- OUTPUT PULL-UP & PULL DOWN
RS485- LINE TERMINATION
RS485 (MAX487)
Driver input(DI): If DE is high. The output terminals A & B are controlled according to DI. If DI>0, V_a > V_b If DI<0, V_b > V_a A pull up resistor is connected to DI. When DI is floating, This pull-up resistor keeps DI positive so that V_a>V_b is achieved (as if device is ot speaking)
If A and B are floating terminals and ~RE pin is LOW, state of RO is not well defined Thus 20k pull-up & pull-down resistors are added to A and B terminals respectively. When A & B are floating The RO pin is HIGH This resistors also keeps V_a > V_b when no device is transmitting
MAX487- RO
MAX487- DI
Power Input
Receiver Output Enable (RO): RO is enabled when ~RE is low; RO is high impedance when ~RE is high if V_a > V_b, RO is high if V_b > V_a, RO is low At Idle, UART RX line should be kept at positive voltage Thus 10K Pull-Up resistor is added to keep line voltage positive when high impedance mode is ac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
Termination resistor (120 Ohm) Use only at the master and at the eol. Purpose is to eliminate reflected EMWs
LoRa (EBYTE E32 433TD20D)
MCU (Arduino Nano)

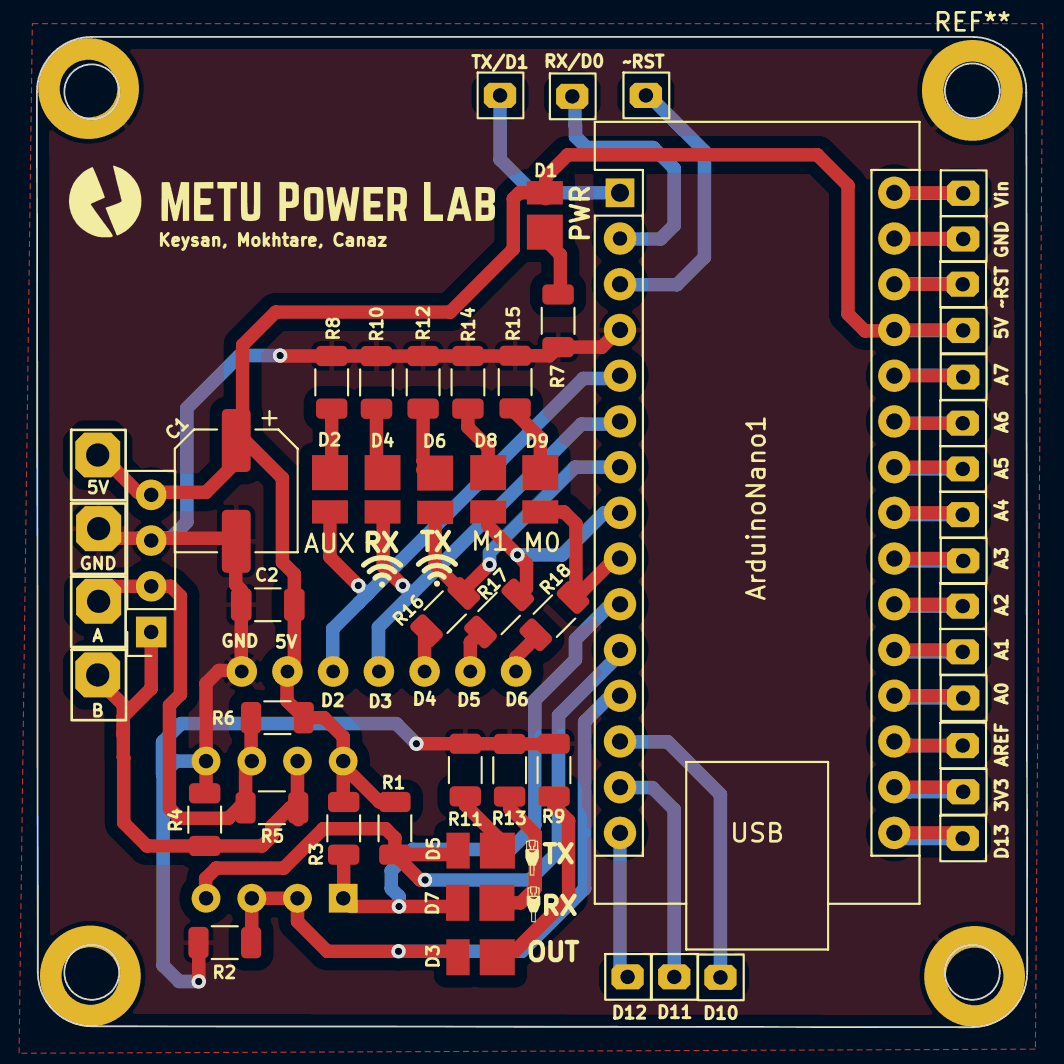
[picture p45: board Device-1.kicad_pcb from above]

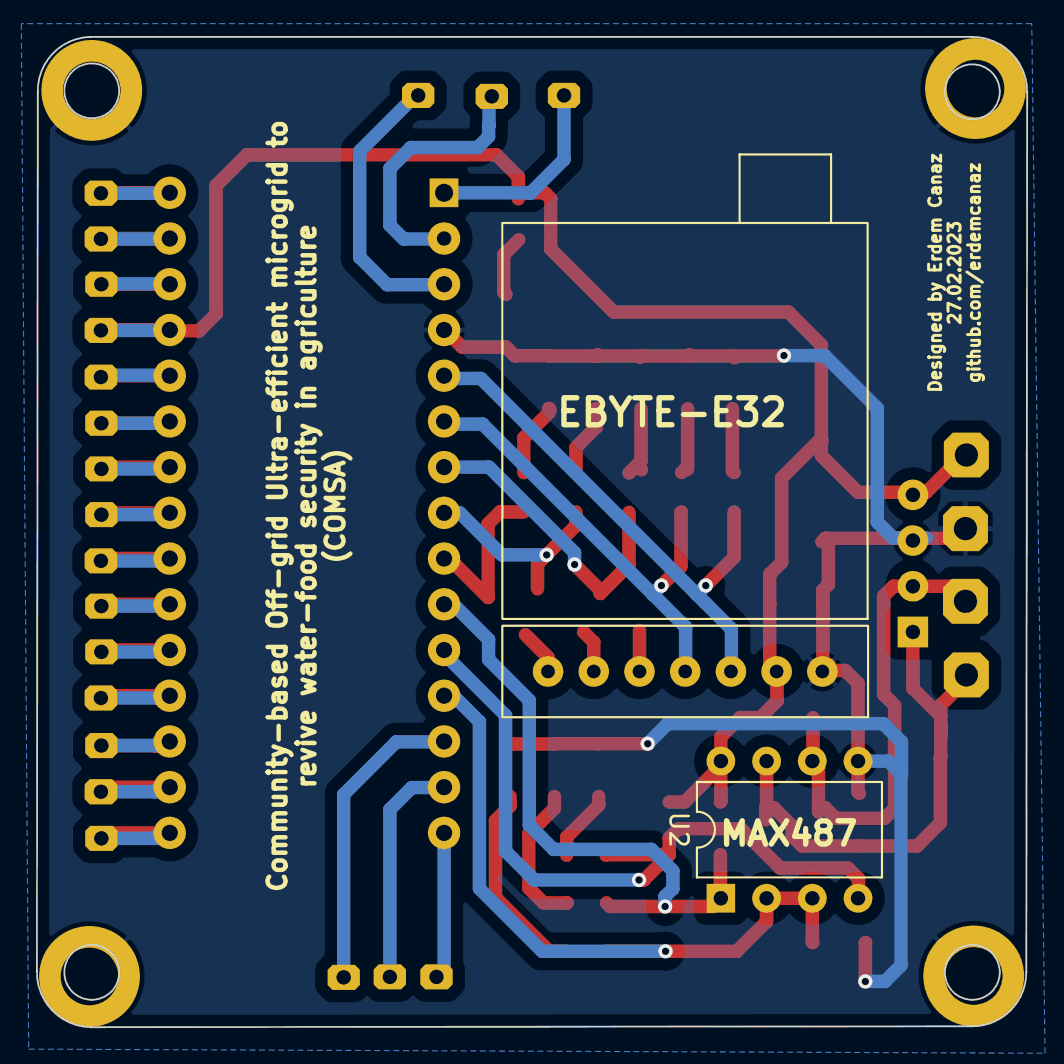
[picture p46: board Device-1.kicad_pcb from below]

Board: 2 copper layers, 55.0 x 55.0 mm, 55 parts (2 on the bottom side), 44 nets.
