erdemcanaz/MODBUS/Devices Codes/device_1_master/device_1_master_script/device_1_master_script.ino

#include <SoftwareSerial.h>
#include "config_pcb.h"

SoftwareSerial LoraSerial(EBYTE_E32_TX_PIN, EBYTE_E32_RX_PIN);  // software Rx, software Tx
SoftwareSerial RS485_Serial(RS485_SOFTWARE_SERIAL_RX_PIN, RS485_SOFTWARE_SERIAL_TX_PIN);

void setup() {
  Serial.begin(HARDWARE_SERIAL_BAUD_RATE);

  configure_RS485_pins();
  RS485_Serial.begin(RS485_SOFTWARE_SERIAL_BAUD_RATE);

  configure_ebyte_pins();
  LoraSerial.begin(LORA_SOFTWARE_SERIAL_BAUD_RATE);
  while (!set_ebyte_parameters(EBYTE_PARAMETERS_DEBUG));  
}

void loop() {
  listen_and_execute_computer_orders();
}
