erdemcanaz/MODBUS/(commit log)

2023-02-22 get_ebyte_parameters
    At this commit, the arduino is able to read the parameters of EBYTE-E32 series devices over software serial.
2023-02-22 set_ebyte_parameters
    In this commit, Arduino automatically overwrites the Ebyte E32 series device parameters. This is important because it allow us to use any device without preconfiguring. Just plug the lora device and it works
2023-02-24 Device 1 Slave and Master is finished
2023-02-25 Arduino status codes
2023-02-25 Device-1 Schematic
    [Device-1.kicad_pcb, Device-1.kicad_sch]
2023-02-25 Device 1 PCB is finished
    [Arduino Nano-STEP.STEP, Arduino Nano.SLDPRT, Device-1.kicad_pcb, Device-1.kicad_sch, E32-433T20DT.stp, e32-433t20dt.X_T]
2023-02-27 slave config.h and tescom_SDDPV2200M
    [Device-1.kicad_pcb, Device-1.kicad_sch]
2023-03-01 PCB and slave fix
    [Device-1.kicad_pcb, Device-1.kicad_sch]
2023-03-01 PCBway gerbers are finished.
    [Device-1-B_Cu.gbl, Device-1-B_Mask.gbs, Device-1-B_Paste.gbp, Device-1-B_Silkscreen.gbo, Device-1-Edge_Cuts.gm1, Device-1-F_Cu.gtl, Device-1-F_Mask.gts, Device-1-F_Paste.gtp]
2023-03-10 Everything works
    1) PCB is finished (use larges holes for LoRa)
    2) Master and slave codes are finished
    [BOM.csv, Device-1.csv, Device-1.kicad_pcb]
2023-03-24 Growat inverter is added as a device
2023-04-05 Simple RS485 modbus slave is added
    [Device-1.kicad_sch]
2023-04-07 water level sensor driver
2023-04-11 Data logging
    [default.csv]
2023-04-12 12 hours of data measurement
    [default.csv]
2023-04-12 csv plotter
    [default_12_04_2023.csv]
2023-04-12 device_tag is added
    knowing the device is important. But there are multiple of the same device. So I have added another column so called device_tag. This basically the human readable form of which device it is. Like, the one at the roof or one at the laboratory.
2023-04-12 live script
    [default_12_04_2023.csv]
2023-04-12 load power logger issue
    [main.py]
2023-04-23 3D lora
    [Lora Casing V9.stl, lora casing v8.stl]
2023-05-09 Device Adress == LORA-ID
2023-06-25 set inverter charging current is added
2023-06-27 run motor at desired frequency is finished
